illinois-ceesd/drivers_y3-prediction/data/cav5_comb2_ui/actii.FCStd

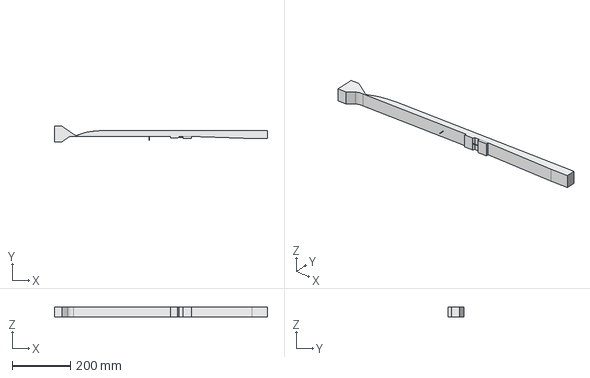
[picture p1: CAD file, 2023-10-13]
data/cav5_comb2_ui/actii.FCStd
728.8 x 54.1 x 35.0 mm
