illinois-ceesd/drivers_y3-prediction/data/cav8_comb2_ui/actii.FCStd

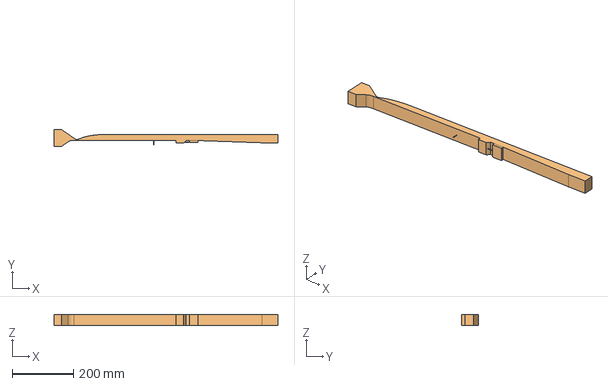
[picture p2: CAD file, 2023-10-13]
data/cav8_comb2_ui/actii.FCStd
728.8 x 54.1 x 35.0 mm
wallSurround
BooleanFragments
