illinois-ceesd/drivers_y3-prediction/data/jet_crossflow/actii_fillet.FCStd

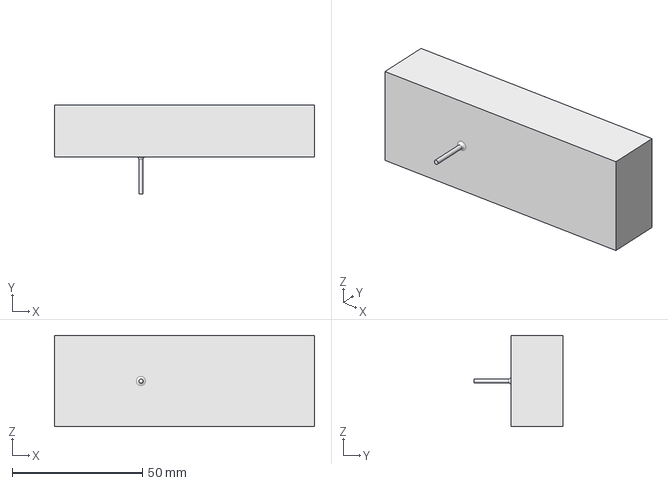
[picture p3: CAD file, 2023-10-16]
data/jet_crossflow/actii_fillet.FCStd
100.0 x 34.2 x 35.0 mm
