illinois-ceesd/drivers_y3-prediction/data/unstart_cr1p3/ACTII_Nozzle_Mach_4p5.STEP

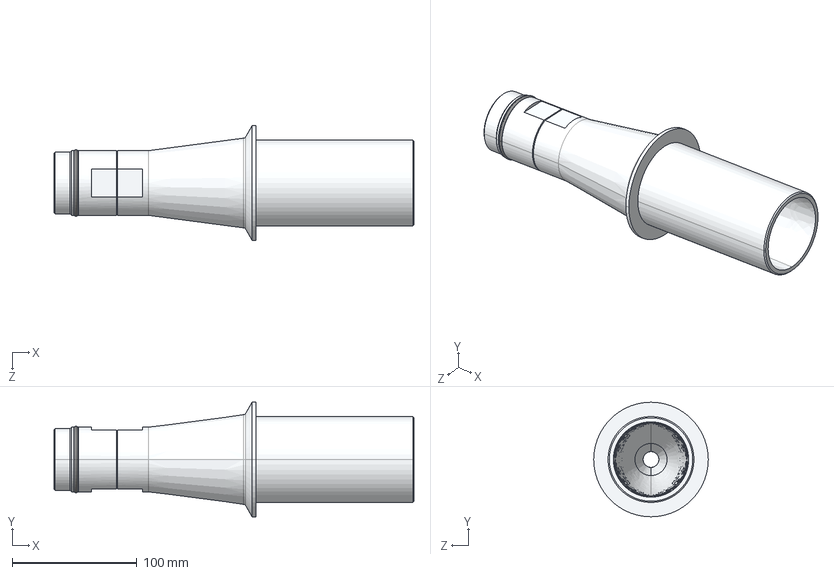
[picture p4: CAD file, 2024-04-18]
data/unstart_cr1p3/ACTII_Nozzle_Mach_4p5.STEP
289.0 x 92.0 x 92.0 mm
Mach-4p5-Divergent-Mod
Mach-4p5-Throat
o-rings_33
o-rings_47
