illinois-ceesd/drivers_y3-prediction/data/cav5_comb4_ui/actii.FCStd

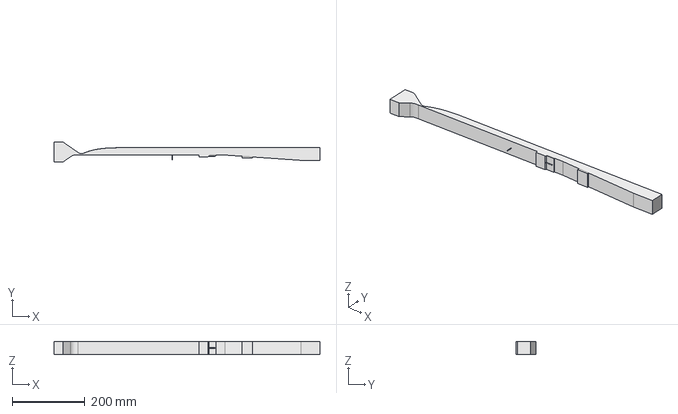
[picture p6: CAD file, 2023-07-18, an earlier design]
data/cav5_comb4_ui/actii.FCStd
728.8 x 54.1 x 35.0 mm
