illinois-ceesd/drivers_y3-prediction/(list of files, cad)

Other CAD files:
data/cav5_comb4/actii.FCStd
data/unstart_cr1p3/pseudoY0_2d.step
data/jet_crossflow/actii.FCStd
data/unstart_cr1p3/pseudoY0_2d.iges
data/unstart_cr1p3/pseudoY0_2d.stl
