illinois-ceesd/drivers_y3-prediction/(threads)

Thread 13 (2023-04-05):

Recent changes appear to render 3D mixtures inoperable

MTCam, 2023-04-05:
It seems that 3D mixtures no longer work after updates to AV/smoothness handling.   This happens on Lassen with a single GPU run in lazy execution mode with the KS feature set, even with `use_av=1`.

Updates:

We shouldn't call compiled functions from functions that are compiled.   There was a compiled function call down inside `unfiltered_rhs` which is itself compiled.   This would trigger with `use_av=1`.  Removing that compiled function call got us up to really long compiles (longer than we're wiling to wait).

Long compiles are mitigated by a liberal use of `force_evaluation` to make double sure we aren't getting any graphs representing constant data down inside the operator call graphs.  Compile times are acceptable now with AV=1, still testing other settings.

The current change set is summarized in #14

```
2023-04-05 03:43:53,438 - INFO - pyopencl - build program: kernel 'frozen_result' was part of a lengthy source build resulting from a binary cache miss (0.64 s)
******** Done Writing Visualization File ********
Traceback (most recent call last):
  File "/p/gpfs1/mtcampbe/CEESD/AutomatedTesting/MIRGE-Timing/timing/y3-prediction-testing/emirge/pytato/pytato/transform/__init__.py", line 190, in rec
    return self._cache[key]
           ~~~~~~~~~~~^^^^^
KeyError: DictOfNamedArrays({'_ary': Placeholder(axes=(Axis(tags=frozenset({DiscretizationElementAxisTag()})), Axis(tags=frozenset({DiscretizationDOFAxisTag()}))), tags={FEMEinsumTag(indices=((FreeEinsumIndex(discr_entity=DiscretizationElementAxisTag(), length=40179), FreeEinsumIndex(discr_entity=DiscretizationDOFAxisTag(), length=35)), (FreeEinsumIndex(discr_entity=DiscretizationElementAxisTag(), length=40179), FreeEinsumIndex(discr_entity=DiscretizationDOFAxisTag(), length=35))))}, shape=(40179, 35), dtype='float64', name='_actx_in_1_2_0')})

During handling of the above exception, another exception occurred:

Traceback (most recent call last):
  File "/p/gpfs1/mtcampbe/CEESD/AutomatedTesting/MIRGE-Timing/timing/y3-prediction-testing/emirge/pytato/pytato/transform/__init__.py", line 190, in rec
    return self._cache[key]
           ~~~~~~~~~~~^^^^^
KeyError: Placeholder(axes=(Axis(tags=frozenset({DiscretizationElementAxisTag()})), Axis(tags=frozenset({DiscretizationDOFAxisTag()}))), tags={FEMEinsumTag(indices=((FreeEinsumIndex(discr_entity=DiscretizationElementAxisTag(), length=40179), FreeEinsumIndex(discr_entity=DiscretizationDOFAxisTag(), length=35)), (FreeEinsumIndex(discr_entity=DiscretizationElementAxisTag(), length=40179), FreeEinsumIndex(discr_entity=DiscretizationDOFAxisTag(), length=35))))}, shape=(40179, 35), dtype='float64', name='_actx_in_1_2_0')

During handling of the above exception, another exception occurred:

Traceback (most recent call last):
  File "<frozen runpy>", line 198, in _run_module_as_main
  File "<frozen runpy>", line 88, in _run_code
  File "/p/gpfs1/mtcampbe/CEESD/AutomatedTesting/MIRGE-Timing/timing/y3-prediction-testing/emirge/miniforge3/envs/testing.y3.production/lib/python3.11/site-packages/mpi4py/__main__.py", line 7, in <module>
    main()
  File "/p/gpfs1/mtcampbe/CEESD/AutomatedTesting/MIRGE-Timing/timing/y3-prediction-testing/emirge/miniforge3/envs/testing.y3.production/lib/python3.11/site-packages/mpi4py/run.py", line 198, in main
    run_command_line(args)
  File "/p/gpfs1/mtcampbe/CEESD/AutomatedTesting/MIRGE-Timing/timing/y3-prediction-testing/emirge/miniforge3/envs/testing.y3.production/lib/python3.11/site-packages/mpi4py/run.py", line 47, in run_command_line
    run_path(sys.argv[0], run_name='__main__')
  File "<frozen runpy>", line 291, in run_path
  File "<frozen runpy>", line 98, in _run_module_code
  File "<frozen runpy>", line 88, in _run_code
  File "./driver.py", line 73, in <module>
    main(restart_filename=restart_filename, target_filename=target_filename,
  File "/p/gpfs1/mtcampbe/CEESD/AutomatedTesting/MIRGE-Timing/timing/y3-prediction-testing/emirge/mirgecom/mirgecom/mpi.py", line 200, in wrapped_func
    func(*args, **kwargs)
  File "/p/gpfs1/mtcampbe/CEESD/AutomatedTesting/MIRGE-Timing/timing/y3-prediction-testing/y3prediction/prediction.py", line 3129, in main
    advance_state(rhs=my_rhs, timestepper=timestepper,
  File "/p/gpfs1/mtcampbe/CEESD/AutomatedTesting/MIRGE-Timing/timing/y3-prediction-testing/emirge/mirgecom/mirgecom/steppers.py", line 439, in advance_state
    _advance_state_stepper_func(
  File "/p/gpfs1/mtcampbe/CEESD/AutomatedTesting/MIRGE-Timing/timing/y3-prediction-testing/emirge/mirgecom/mirgecom/steppers.py", line 164, in _advance_state_stepper_func
    state = timestepper(state=state, t=t, dt=dt, rhs=maybe_compiled_rhs)
            ^^^^^^^^^^^^^^^^^^^^^^^^^^^^^^^^^^^^^^^^^^^^^^^^^^^^^^^^^^^^
  File "/p/gpfs1/mtcampbe/CEESD/AutomatedTesting/MIRGE-Timing/timing/y3-prediction-testing/y3prediction/prediction.py", line 588, in _compiled_stepper_wrapper
    return compiled_lsrk45_step(actx, state, t, dt, rhs)
           ^^^^^^^^^^^^^^^^^^^^^^^^^^^^^^^^^^^^^^^^^^^^^
  File "/p/gpfs1/mtcampbe/CEESD/AutomatedTesting/MIRGE-Timing/timing/y3-prediction-testing/emirge/grudge/grudge/shortcuts.py", line 56, in compiled_lsrk45_step
    rhs_val = f(t + c*h, y)
              ^^^^^^^^^^^^^
  File "/p/gpfs1/mtcampbe/CEESD/AutomatedTesting/MIRGE-Timing/timing/y3-prediction-testing/y3prediction/prediction.py", line 3113, in my_rhs
    unfiltered_rhs_compiled(t, state)
  File "/p/gpfs1/mtcampbe/CEESD/AutomatedTesting/MIRGE-Timing/timing/y3-prediction-testing/emirge/arraycontext/arraycontext/impl/pytato/compile.py", line 337, in __call__
    output_template = self.f(
                      ^^^^^^^
  File "/p/gpfs1/mtcampbe/CEESD/AutomatedTesting/MIRGE-Timing/timing/y3-prediction-testing/y3prediction/prediction.py", line 2800, in unfiltered_rhs
    smoothness_mu = compute_smoothness_compiled(
                    ^^^^^^^^^^^^^^^^^^^^^^^^^^^^
  File "/p/gpfs1/mtcampbe/CEESD/AutomatedTesting/MIRGE-Timing/timing/y3-prediction-testing/emirge/arraycontext/arraycontext/impl/pytato/compile.py", line 329, in __call__
    return compiled_f(arg_id_to_arg)
           ^^^^^^^^^^^^^^^^^^^^^^^^^
  File "/p/gpfs1/mtcampbe/CEESD/AutomatedTesting/MIRGE-Timing/timing/y3-prediction-testing/emirge/grudge/grudge/array_context.py", line 380, in __call__
    input_args_for_prg = _args_to_device_buffers(
                         ^^^^^^^^^^^^^^^^^^^^^^^^
  File "/p/gpfs1/mtcampbe/CEESD/AutomatedTesting/MIRGE-Timing/timing/y3-prediction-testing/emirge/arraycontext/arraycontext/impl/pytato/compile.py", line 555, in _args_to_device_buffers
    arg = actx.freeze(arg)
          ^^^^^^^^^^^^^^^^
  File "/p/gpfs1/mtcampbe/CEESD/AutomatedTesting/MIRGE-Timing/timing/y3-prediction-testing/emirge/arraycontext/arraycontext/impl/pytato/__init__.py", line 491, in freeze
    normalized_expr, bound_arguments = _normalize_pt_expr(
                                       ^^^^^^^^^^^^^^^^^^^
  File "/p/gpfs1/mtcampbe/CEESD/AutomatedTesting/MIRGE-Timing/timing/y3-prediction-testing/emirge/arraycontext/arraycontext/impl/pytato/utils.py", line 92, in _normalize_pt_expr
    normalized_expr = normalize_mapper(expr)
                      ^^^^^^^^^^^^^^^^^^^^^^
  File "/p/gpfs1/mtcampbe/CEESD/AutomatedTesting/MIRGE-Timing/timing/y3-prediction-testing/emirge/pytato/pytato/transform/__init__.py", line 213, in __call__
    return self.rec(expr)  # type: ignore[no-any-return]
           ^^^^^^^^^^^^^^
  File "/p/gpfs1/mtcampbe/CEESD/AutomatedTesting/MIRGE-Timing/timing/y3-prediction-testing/emirge/pytato/pytato/transform/__init__.py", line 192, in rec
    result = super().rec(expr)  # type: ignore[type-var]
             ^^^^^^^^^^^^^^^^^
  File "/p/gpfs1/mtcampbe/CEESD/AutomatedTesting/MIRGE-Timing/timing/y3-prediction-testing/emirge/pytato/pytato/transform/__init__.py", line 163, in rec
    return method(expr, *args, **kwargs)
           ^^^^^^^^^^^^^^^^^^^^^^^^^^^^^
  File "/p/gpfs1/mtcampbe/CEESD/AutomatedTesting/MIRGE-Timing/timing/y3-prediction-testing/emirge/pytato/pytato/transform/__init__.py", line 307, in map_dict_of_named_arrays
    return DictOfNamedArrays({key: self.rec(val.expr)
                             ^^^^^^^^^^^^^^^^^^^^^^^^
  File "/p/gpfs1/mtcampbe/CEESD/AutomatedTesting/MIRGE-Timing/timing/y3-prediction-testing/emirge/pytato/pytato/transform/__init__.py", line 307, in <dictcomp>
    return DictOfNamedArrays({key: self.rec(val.expr)
                                   ^^^^^^^^^^^^^^^^^^
  File "/p/gpfs1/mtcampbe/CEESD/AutomatedTesting/MIRGE-Timing/timing/y3-prediction-testing/emirge/pytato/pytato/transform/__init__.py", line 192, in rec
    result = super().rec(expr)  # type: ignore[type-var]
             ^^^^^^^^^^^^^^^^^
  File "/p/gpfs1/mtcampbe/CEESD/AutomatedTesting/MIRGE-Timing/timing/y3-prediction-testing/emirge/pytato/pytato/transform/__init__.py", line 163, in rec
    return method(expr, *args, **kwargs)
           ^^^^^^^^^^^^^^^^^^^^^^^^^^^^^
  File "/p/gpfs1/mtcampbe/CEESD/AutomatedTesting/MIRGE-Timing/timing/y3-prediction-testing/emirge/arraycontext/arraycontext/impl/pytato/utils.py", line 76, in map_placeholder
    raise ValueError("Placeholders cannot appear in"
ValueError: Placeholders cannot appear in DatawrapperToBoundPlaceholderMapper.
--------------------------------------------------------------------------
MPI_ABORT was invoked on rank 0 in communicator MPI_COMM_WORLD
with errorcode 1.

NOTE: invoking MPI_ABORT causes Open MPI to kill all MPI processes.
You may or may not see output from other processes, depending on
exactly when Open MPI kills them.
--------------------------------------------------------------------------
```

Closed 2023-04-17.

Thread 19 (2023-04-17):

Large(ish) cases don't work with current driver@main

MTCam, 2023-04-17:
Scalability case on 128 ranks have started to fail with current driver@main.  Before recent changes, the code ran up to 512 ranks without issue.  Only the 128 rank case fails with this error.  512 has not been tested since this trouble started.

more details will follow, just want to get this on the radar.

```
2023-04-17 07:11:35,502 - INFO - meshmode.array_context - Array Contraction: completed (135.71s wall 1.00x CPU)
2023-04-17 07:11:35,503 - INFO - arraycontext.impl.pytato.compile - transform_loopy_program for 'unfiltered_rhs': completed (355.22s wall 1.00x CPU)
Traceback (most recent call last):
  File "<frozen runpy>", line 198, in _run_module_as_main
  File "<frozen runpy>", line 88, in _run_code
  File "/p/gpfs1/mtcampbe/CEESD/AutomatedTesting/MIRGE-Timing/timing/y3-prediction-testing/emirge/miniforge3/envs/prediction.env/lib/python3.11/site-packages/mpi4py/__main__.py", line 7, in <module>
    main()
  File "/p/gpfs1/mtcampbe/CEESD/AutomatedTesting/MIRGE-Timing/timing/y3-prediction-testing/emirge/miniforge3/envs/prediction.env/lib/python3.11/site-packages/mpi4py/run.py", line 198, in main
    run_command_line(args)
  File "/p/gpfs1/mtcampbe/CEESD/AutomatedTesting/MIRGE-Timing/timing/y3-prediction-testing/emirge/miniforge3/envs/prediction.env/lib/python3.11/site-packages/mpi4py/run.py", line 47, in run_command_line
    run_path(sys.argv[0], run_name='__main__')
  File "<frozen runpy>", line 291, in run_path
  File "<frozen runpy>", line 98, in _run_module_code
  File "<frozen runpy>", line 88, in _run_code
  File "driver.py", line 73, in <module>
    main(restart_filename=restart_filename, target_filename=target_filename,
  File "/p/gpfs1/mtcampbe/CEESD/AutomatedTesting/MIRGE-Timing/timing/y3-prediction-testing/emirge/mirgecom/mirgecom/mpi.py", line 200, in wrapped_func
    func(*args, **kwargs)
  File "/p/gpfs1/mtcampbe/CEESD/AutomatedTesting/MIRGE-Timing/timing/y3-prediction-testing/y3prediction/prediction.py", line 3096, in main
    advance_state(rhs=my_rhs, timestepper=timestepper,
  File "/p/gpfs1/mtcampbe/CEESD/AutomatedTesting/MIRGE-Timing/timing/y3-prediction-testing/emirge/mirgecom/mirgecom/steppers.py", line 439, in advance_state
    _advance_state_stepper_func(
  File "/p/gpfs1/mtcampbe/CEESD/AutomatedTesting/MIRGE-Timing/timing/y3-prediction-testing/emirge/mirgecom/mirgecom/steppers.py", line 164, in _advance_state_stepper_func
    state = timestepper(state=state, t=t, dt=dt, rhs=maybe_compiled_rhs)
            ^^^^^^^^^^^^^^^^^^^^^^^^^^^^^^^^^^^^^^^^^^^^^^^^^^^^^^^^^^^^
  File "/p/gpfs1/mtcampbe/CEESD/AutomatedTesting/MIRGE-Timing/timing/y3-prediction-testing/y3prediction/prediction.py", line 608, in _compiled_stepper_wrapper
    return compiled_lsrk45_step(actx, state, t, dt, rhs)
           ^^^^^^^^^^^^^^^^^^^^^^^^^^^^^^^^^^^^^^^^^^^^^
  File "/p/gpfs1/mtcampbe/CEESD/AutomatedTesting/MIRGE-Timing/timing/y3-prediction-testing/emirge/grudge/grudge/shortcuts.py", line 56, in compiled_lsrk45_step
    rhs_val = f(t + c*h, y)
              ^^^^^^^^^^^^^
  File "/p/gpfs1/mtcampbe/CEESD/AutomatedTesting/MIRGE-Timing/timing/y3-prediction-testing/y3prediction/prediction.py", line 3078, in my_rhs
    unfiltered_rhs_compiled(t, state)
  File "/p/gpfs1/mtcampbe/CEESD/AutomatedTesting/MIRGE-Timing/timing/y3-prediction-testing/emirge/arraycontext/arraycontext/impl/pytato/compile.py", line 366, in __call__
    compiled_func = self._dag_to_compiled_func(
                    ^^^^^^^^^^^^^^^^^^^^^^^^^^^
  File "/p/gpfs1/mtcampbe/CEESD/AutomatedTesting/MIRGE-Timing/timing/y3-prediction-testing/emirge/grudge/grudge/array_context.py", line 307, in _dag_to_compiled_func
    ) = self._dag_to_transformed_pytato_prg(
        ^^^^^^^^^^^^^^^^^^^^^^^^^^^^^^^^^^^^
  File "/p/gpfs1/mtcampbe/CEESD/AutomatedTesting/MIRGE-Timing/timing/y3-prediction-testing/emirge/arraycontext/arraycontext/impl/pytato/compile.py", line 442, in _dag_to_transformed_pytato_prg
    .with_transformed_program(self
     ^^^^^^^^^^^^^^^^^^^^^^^^^^^^^
  File "/p/gpfs1/mtcampbe/CEESD/AutomatedTesting/MIRGE-Timing/timing/y3-prediction-testing/emirge/pytato/pytato/target/loopy/__init__.py", line 151, in with_transformed_program
    return self.copy(program=f(self.program))
                             ^^^^^^^^^^^^^^^
  File "/p/gpfs1/mtcampbe/CEESD/AutomatedTesting/MIRGE-Timing/timing/y3-prediction-testing/emirge/meshmode/meshmode/array_context.py", line 1741, in transform_loopy_program
    raise err
  File "/p/gpfs1/mtcampbe/CEESD/AutomatedTesting/MIRGE-Timing/timing/y3-prediction-testing/emirge/meshmode/meshmode/array_context.py", line 1738, in transform_loopy_program
    iel_to_idofs = _get_iel_to_idofs(knl)
                   ^^^^^^^^^^^^^^^^^^^^^^
  File "/p/gpfs1/mtcampbe/CEESD/AutomatedTesting/MIRGE-Timing/timing/y3-prediction-testing/emirge/meshmode/meshmode/array_context.py", line 1068, in _get_iel_to_idofs
    raise NotImplementedError(f"Cannot fit loop nest '{insn.within_inames}'"
NotImplementedError: Cannot fit loop nest 'frozenset({'idof_ensm14'})' into known set of loop-nest patterns.
2023-04-17 07:11:36,495 - INFO - loopy.codegen - unfiltered_rhs: generate code: completed (16.88s wall 1.00x CPU)
2023-04-17 07:11:36,664 - INFO - loopy.schedule - unfiltered_rhs: schedule: completed (11.42s wall 1.00x CPU)
2023-04-17 07:11:37,738 - INFO - loopy.tools - contract_arrays on 'unfiltered_rhs': completed (130.51s wall 1.00x CPU)
2023-04-17 07:11:37,981 - INFO - pyopencl - build program: kernel 'unfiltered_rhs' was part of a lengthy source build resulting from a binary cache miss (6.77 s)
2023-04-17 07:11:39,042 - INFO - loopy.schedule - unfiltered_rhs: schedule: completed (10.97s wall 1.00x CPU)
2023-04-17 07:11:39,709 - INFO - loopy.codegen - unfiltered_rhs: generate code: completed (18.08s wall 1.00x CPU)
2023-04-17 07:11:39,800 - INFO - loopy.schedule - unfiltered_rhs: schedule: completed (4.37s wall 1.00x CPU)
2023-04-17 07:11:40,367 - INFO - loopy.schedule - unfiltered_rhs: schedule: completed (18.51s wall 1.00x CPU)
2023-04-17 07:11:40,484 - INFO - meshmode.array_context - Array Contraction: completed (138.73s wall 1.00x CPU)
2023-04-17 07:11:40,486 - INFO - arraycontext.impl.pytato.compile - transform_loopy_program for 'unfiltered_rhs': completed (357.87s wall 1.00x CPU)
Traceback (most recent call last):
  File "<frozen runpy>", line 198, in _run_module_as_main
  File "<frozen runpy>", line 88, in _run_code
  File "/p/gpfs1/mtcampbe/CEESD/AutomatedTesting/MIRGE-Timing/timing/y3-prediction-testing/emirge/miniforge3/envs/prediction.env/lib/python3.11/site-packages/mpi4py/__main__.py", line 7, in <module>
    main()
  File "/p/gpfs1/mtcampbe/CEESD/AutomatedTesting/MIRGE-Timing/timing/y3-prediction-testing/emirge/miniforge3/envs/prediction.env/lib/python3.11/site-packages/mpi4py/run.py", line 198, in main
    run_command_line(args)
  File "/p/gpfs1/mtcampbe/CEESD/AutomatedTesting/MIRGE-Timing/timing/y3-prediction-testing/emirge/miniforge3/envs/prediction.env/lib/python3.11/site-packages/mpi4py/run.py", line 47, in run_command_line
    run_path(sys.argv[0], run_name='__main__')
  File "<frozen runpy>", line 291, in run_path
  File "<frozen runpy>", line 98, in _run_module_code
  File "<frozen runpy>", line 88, in _run_code
  File "driver.py", line 73, in <module>
    main(restart_filename=restart_filename, target_filename=target_filename,
  File "/p/gpfs1/mtcampbe/CEESD/AutomatedTesting/MIRGE-Timing/timing/y3-prediction-testing/emirge/mirgecom/mirgecom/mpi.py", line 200, in wrapped_func
    func(*args, **kwargs)
  File "/p/gpfs1/mtcampbe/CEESD/AutomatedTesting/MIRGE-Timing/timing/y3-prediction-testing/y3prediction/prediction.py", line 3096, in main
    advance_state(rhs=my_rhs, timestepper=timestepper,
  File "/p/gpfs1/mtcampbe/CEESD/AutomatedTesting/MIRGE-Timing/timing/y3-prediction-testing/emirge/mirgecom/mirgecom/steppers.py", line 439, in advance_state
    _advance_state_stepper_func(
  File "/p/gpfs1/mtcampbe/CEESD/AutomatedTesting/MIRGE-Timing/timing/y3-prediction-testing/emirge/mirgecom/mirgecom/steppers.py", line 164, in _advance_state_stepper_func
    state = timestepper(state=state, t=t, dt=dt, rhs=maybe_compiled_rhs)
            ^^^^^^^^^^^^^^^^^^^^^^^^^^^^^^^^^^^^^^^^^^^^^^^^^^^^^^^^^^^^
  File "/p/gpfs1/mtcampbe/CEESD/AutomatedTesting/MIRGE-Timing/timing/y3-prediction-testing/y3prediction/prediction.py", line 608, in _compiled_stepper_wrapper
    return compiled_lsrk45_step(actx, state, t, dt, rhs)
           ^^^^^^^^^^^^^^^^^^^^^^^^^^^^^^^^^^^^^^^^^^^^^
  File "/p/gpfs1/mtcampbe/CEESD/AutomatedTesting/MIRGE-Timing/timing/y3-prediction-testing/emirge/grudge/grudge/shortcuts.py", line 56, in compiled_lsrk45_step
    rhs_val = f(t + c*h, y)
              ^^^^^^^^^^^^^
  File "/p/gpfs1/mtcampbe/CEESD/AutomatedTesting/MIRGE-Timing/timing/y3-prediction-testing/y3prediction/prediction.py", line 3078, in my_rhs
    unfiltered_rhs_compiled(t, state)
  File "/p/gpfs1/mtcampbe/CEESD/AutomatedTesting/MIRGE-Timing/timing/y3-prediction-testing/emirge/arraycontext/arraycontext/impl/pytato/compile.py", line 366, in __call__
    compiled_func = self._dag_to_compiled_func(
                    ^^^^^^^^^^^^^^^^^^^^^^^^^^^
  File "/p/gpfs1/mtcampbe/CEESD/AutomatedTesting/MIRGE-Timing/timing/y3-prediction-testing/emirge/grudge/grudge/array_context.py", line 307, in _dag_to_compiled_func
    ) = self._dag_to_transformed_pytato_prg(
        ^^^^^^^^^^^^^^^^^^^^^^^^^^^^^^^^^^^^
  File "/p/gpfs1/mtcampbe/CEESD/AutomatedTesting/MIRGE-Timing/timing/y3-prediction-testing/emirge/arraycontext/arraycontext/impl/pytato/compile.py", line 442, in _dag_to_transformed_pytato_prg
    .with_transformed_program(self
     ^^^^^^^^^^^^^^^^^^^^^^^^^^^^^
  File "/p/gpfs1/mtcampbe/CEESD/AutomatedTesting/MIRGE-Timing/timing/y3-prediction-testing/emirge/pytato/pytato/target/loopy/__init__.py", line 151, in with_transformed_program
    return self.copy(program=f(self.program))
                             ^^^^^^^^^^^^^^^
  File "/p/gpfs1/mtcampbe/CEESD/AutomatedTesting/MIRGE-Timing/timing/y3-prediction-testing/emirge/meshmode/meshmode/array_context.py", line 1741, in transform_loopy_program
    raise err
  File "/p/gpfs1/mtcampbe/CEESD/AutomatedTesting/MIRGE-Timing/timing/y3-prediction-testing/emirge/meshmode/meshmode/array_context.py", line 1738, in transform_loopy_program
    iel_to_idofs = _get_iel_to_idofs(knl)
                   ^^^^^^^^^^^^^^^^^^^^^^
  File "/p/gpfs1/mtcampbe/CEESD/AutomatedTesting/MIRGE-Timing/timing/y3-prediction-testing/emirge/meshmode/meshmode/array_context.py", line 1068, in _get_iel_to_idofs
    raise NotImplementedError(f"Cannot fit loop nest '{insn.within_inames}'"
NotImplementedError: Cannot fit loop nest 'frozenset({'idof_ensm16'})' into known set of loop-nest patterns.
2023-04-17 07:11:41,867 - INFO - loopy.schedule - unfiltered_rhs: schedule: completed (11.63s wall 1.00x CPU)
2023-04-17 07:11:43,640 - INFO - loopy.tools - contract_arrays on 'unfiltered_rhs': completed (128.28s wall 1.00x CPU)
```

ZwFink, 2023-09-18:
This is happening to me on `smoke_test_ks_3d` using 4 ranks.
````bash
  File "/usr/WS2/fink12/drivers_y3-prediction/emirge/meshmode/meshmode/array_context.py", line 1068, in _get_iel_to_idofs
    raise NotImplementedError(f"Cannot fit loop nest '{insn.within_inames}'"
NotImplementedError: Cannot fit loop nest 'frozenset({'idof_ensm2'})' into known set of loop-nest patterns.
```

Am I the only one?

majosm, 2023-09-18:
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

https://github.com/illinois-ceesd/mirgecom/issues/944

A fix is still TBD. Depending on what you're doing, you may be able to avoid it by setting `use_wall: False` in `run_params.yaml`.

Closed 2024-05-07.

Thread 27 (2023-04-26):

ESDG status and failure

MTCam, 2023-04-26:
Here's the current state of ESDG in prediction.   To reproduce, checkout from #26, use `buildMirge.sh` (or install mirgecom@production-esdg), and try to run smoke test or anything else with `--esdg` option.   This works on single-volume cases, but not with multivolume.  Here's the current error:

```
Traceback (most recent call last):
  File "/p/gpfs1/mtcampbe/CEESD/AutomatedTesting/MIRGE-Timing/esdg.testing/emirge/miniforge3/envs/production.esdg/lib/python3.11/site-packages/pytools/__init__.py", line 931, in new_inner
    return self.cache_dict[args]
           ~~~~~~~~~~~~~~~^^^^^^
KeyError: ()

During handling of the above exception, another exception occurred:

Traceback (most recent call last):
  File "/p/gpfs1/mtcampbe/CEESD/AutomatedTesting/MIRGE-Timing/esdg.testing/emirge/miniforge3/envs/production.esdg/lib/python3.11/site-packages/pytools/__init__.py", line 931, in new_inner
    return self.cache_dict[args]
           ~~~~~~~~~~~~~~~^^^^^^
KeyError: ()

During handling of the above exception, another exception occurred:

Traceback (most recent call last):
  File "/p/gpfs1/mtcampbe/CEESD/AutomatedTesting/MIRGE-Timing/esdg.testing/emirge/grudge/grudge/discretization.py", line 601, in _volume_discr_from_dd
    base_volume_discr = self._volume_discrs[dd.domain_tag.tag]
                        ~~~~~~~~~~~~~~~~~~~^^^^^^^^^^^^^^^^^^^
KeyError: <class 'grudge.dof_desc.VTAG_ALL'>

During handling of the above exception, another exception occurred:

Traceback (most recent call last):
  File "<frozen runpy>", line 198, in _run_module_as_main
  File "<frozen runpy>", line 88, in _run_code
  File "/p/gpfs1/mtcampbe/CEESD/AutomatedTesting/MIRGE-Timing/esdg.testing/emirge/miniforge3/envs/production.esdg/lib/python3.11/site-packages/mpi4py/__main__.py", line 7, in <module>
    main()
  File "/p/gpfs1/mtcampbe/CEESD/AutomatedTesting/MIRGE-Timing/esdg.testing/emirge/miniforge3/envs/production.esdg/lib/python3.11/site-packages/mpi4py/run.py", line 198, in main
    run_command_line(args)
  File "/p/gpfs1/mtcampbe/CEESD/AutomatedTesting/MIRGE-Timing/esdg.testing/emirge/miniforge3/envs/production.esdg/lib/python3.11/site-packages/mpi4py/run.py", line 47, in run_command_line
    run_path(sys.argv[0], run_name='__main__')
  File "<frozen runpy>", line 291, in run_path
  File "<frozen runpy>", line 98, in _run_module_code
  File "<frozen runpy>", line 88, in _run_code
  File "./driver.py", line 75, in <module>
    main(restart_filename=restart_filename, target_filename=target_filename,
  File "/p/gpfs1/mtcampbe/CEESD/AutomatedTesting/MIRGE-Timing/esdg.testing/emirge/mirgecom/mirgecom/mpi.py", line 200, in wrapped_func
    func(*args, **kwargs)
  File "/p/gpfs1/mtcampbe/CEESD/AutomatedTesting/MIRGE-Timing/esdg.testing/y3prediction/prediction.py", line 3066, in main
    advance_state(rhs=my_rhs, timestepper=timestepper,
  File "/p/gpfs1/mtcampbe/CEESD/AutomatedTesting/MIRGE-Timing/esdg.testing/emirge/mirgecom/mirgecom/steppers.py", line 439, in advance_state
    _advance_state_stepper_func(
  File "/p/gpfs1/mtcampbe/CEESD/AutomatedTesting/MIRGE-Timing/esdg.testing/emirge/mirgecom/mirgecom/steppers.py", line 164, in _advance_state_stepper_func
    state = timestepper(state=state, t=t, dt=dt, rhs=maybe_compiled_rhs)
            ^^^^^^^^^^^^^^^^^^^^^^^^^^^^^^^^^^^^^^^^^^^^^^^^^^^^^^^^^^^^
  File "/p/gpfs1/mtcampbe/CEESD/AutomatedTesting/MIRGE-Timing/esdg.testing/emirge/mirgecom/mirgecom/integrators/lsrk.py", line 67, in euler_step
    return lsrk_step(EulerCoefs, state, t, dt, rhs)
           ^^^^^^^^^^^^^^^^^^^^^^^^^^^^^^^^^^^^^^^^
  File "/p/gpfs1/mtcampbe/CEESD/AutomatedTesting/MIRGE-Timing/esdg.testing/emirge/mirgecom/mirgecom/integrators/lsrk.py", line 53, in lsrk_step
    k = coefs.A[i]*k + dt*rhs(t + coefs.C[i]*dt, state)
                          ^^^^^^^^^^^^^^^^^^^^^^^^^^^^^
  File "/p/gpfs1/mtcampbe/CEESD/AutomatedTesting/MIRGE-Timing/esdg.testing/y3prediction/prediction.py", line 3050, in my_rhs
    unfiltered_rhs_compiled(t, state)
  File "/p/gpfs1/mtcampbe/CEESD/AutomatedTesting/MIRGE-Timing/esdg.testing/emirge/arraycontext/arraycontext/impl/pytato/compile.py", line 337, in __call__
    output_template = self.f(
                      ^^^^^^^
  File "/p/gpfs1/mtcampbe/CEESD/AutomatedTesting/MIRGE-Timing/esdg.testing/y3prediction/prediction.py", line 2891, in unfiltered_rhs
    ns_rhs, wall_energy_rhs = coupled_ns_heat_operator(
                              ^^^^^^^^^^^^^^^^^^^^^^^^^
  File "/p/gpfs1/mtcampbe/CEESD/AutomatedTesting/MIRGE-Timing/esdg.testing/emirge/mirgecom/mirgecom/multiphysics/thermally_coupled_fluid_wall.py", line 1275, in coupled_ns_heat_operator
    fluid_op_result = fluid_operator(
                      ^^^^^^^^^^^^^^^
  File "/p/gpfs1/mtcampbe/CEESD/AutomatedTesting/MIRGE-Timing/esdg.testing/emirge/mirgecom/mirgecom/navierstokes.py", line 642, in entropy_stable_ns_operator
    -volume_flux_differencing(dcoll, dd_vol_quad, dd_allfaces_quad,
     ^^^^^^^^^^^^^^^^^^^^^^^^^^^^^^^^^^^^^^^^^^^^^^^^^^^^^^^^^^^^^^
  File "/p/gpfs1/mtcampbe/CEESD/AutomatedTesting/MIRGE-Timing/esdg.testing/emirge/grudge/grudge/flux_differencing.py", line 265, in volume_flux_differencing
    return rec_map_subarrays(
           ^^^^^^^^^^^^^^^^^^
  File "/p/gpfs1/mtcampbe/CEESD/AutomatedTesting/MIRGE-Timing/esdg.testing/emirge/grudge/grudge/tools.py", line 208, in rec_map_subarrays
    return map_array_container(
           ^^^^^^^^^^^^^^^^^^^^
  File "/p/gpfs1/mtcampbe/CEESD/AutomatedTesting/MIRGE-Timing/esdg.testing/emirge/arraycontext/arraycontext/container/traversal.py", line 274, in map_array_container
    return deserialize_container(ary, [
                                      ^
  File "/p/gpfs1/mtcampbe/CEESD/AutomatedTesting/MIRGE-Timing/esdg.testing/emirge/arraycontext/arraycontext/container/traversal.py", line 275, in <listcomp>
    (key, f(subary)) for key, subary in iterable
          ^^^^^^^^^
  File "/p/gpfs1/mtcampbe/CEESD/AutomatedTesting/MIRGE-Timing/esdg.testing/emirge/grudge/grudge/tools.py", line 204, in rec_map_subarrays
    return map_subarrays(
           ^^^^^^^^^^^^^^
  File "/p/gpfs1/mtcampbe/CEESD/AutomatedTesting/MIRGE-Timing/esdg.testing/emirge/grudge/grudge/tools.py", line 141, in map_subarrays
    return f(ary)
           ^^^^^^
  File "/p/gpfs1/mtcampbe/CEESD/AutomatedTesting/MIRGE-Timing/esdg.testing/emirge/grudge/grudge/flux_differencing.py", line 260, in _hybridized_div
    return sum(_single_axis_hybridized_derivative_kernel(
           ^^^^^^^^^^^^^^^^^^^^^^^^^^^^^^^^^^^^^^^^^^^^^^
  File "/p/gpfs1/mtcampbe/CEESD/AutomatedTesting/MIRGE-Timing/esdg.testing/emirge/grudge/grudge/flux_differencing.py", line 260, in <genexpr>
    return sum(_single_axis_hybridized_derivative_kernel(
               ^^^^^^^^^^^^^^^^^^^^^^^^^^^^^^^^^^^^^^^^^^
  File "/p/gpfs1/mtcampbe/CEESD/AutomatedTesting/MIRGE-Timing/esdg.testing/emirge/grudge/grudge/flux_differencing.py", line 218, in _single_axis_hybridized_derivative_kernel
    inverse_jac_matrix()
  File "/p/gpfs1/mtcampbe/CEESD/AutomatedTesting/MIRGE-Timing/esdg.testing/emirge/grudge/grudge/flux_differencing.py", line 188, in inverse_jac_matrix
    return _inv_surf_metric_deriv()
           ^^^^^^^^^^^^^^^^^^^^^^^^
  File "/p/gpfs1/mtcampbe/CEESD/AutomatedTesting/MIRGE-Timing/esdg.testing/emirge/miniforge3/envs/production.esdg/lib/python3.11/site-packages/pytools/__init__.py", line 933, in new_inner
    result = inner(*args)
             ^^^^^^^^^^^^
  File "/p/gpfs1/mtcampbe/CEESD/AutomatedTesting/MIRGE-Timing/esdg.testing/emirge/grudge/grudge/flux_differencing.py", line 171, in _inv_surf_metric_deriv
    [
  File "/p/gpfs1/mtcampbe/CEESD/AutomatedTesting/MIRGE-Timing/esdg.testing/emirge/grudge/grudge/flux_differencing.py", line 173, in <listcomp>
    [
  File "/p/gpfs1/mtcampbe/CEESD/AutomatedTesting/MIRGE-Timing/esdg.testing/emirge/grudge/grudge/flux_differencing.py", line 176, in <listcomp>
    area_element(actx, dcoll)
  File "/p/gpfs1/mtcampbe/CEESD/AutomatedTesting/MIRGE-Timing/esdg.testing/emirge/grudge/grudge/geometry/metrics.py", line 672, in area_element
    return actx.thaw(_area_elements())
                     ^^^^^^^^^^^^^^^^
  File "/p/gpfs1/mtcampbe/CEESD/AutomatedTesting/MIRGE-Timing/esdg.testing/emirge/miniforge3/envs/production.esdg/lib/python3.11/site-packages/pytools/__init__.py", line 933, in new_inner
    result = inner(*args)
             ^^^^^^^^^^^^
  File "/p/gpfs1/mtcampbe/CEESD/AutomatedTesting/MIRGE-Timing/esdg.testing/emirge/grudge/grudge/geometry/metrics.py", line 665, in _area_elements
    pseudoscalar(
  File "/p/gpfs1/mtcampbe/CEESD/AutomatedTesting/MIRGE-Timing/esdg.testing/emirge/grudge/grudge/geometry/metrics.py", line 637, in pseudoscalar
    return parametrization_derivative(
           ^^^^^^^^^^^^^^^^^^^^^^^^^^^
  File "/p/gpfs1/mtcampbe/CEESD/AutomatedTesting/MIRGE-Timing/esdg.testing/emirge/grudge/grudge/geometry/metrics.py", line 601, in parametrization_derivative
    dim = dcoll.discr_from_dd(dd).dim
          ^^^^^^^^^^^^^^^^^^^^^^^
  File "/p/gpfs1/mtcampbe/CEESD/AutomatedTesting/MIRGE-Timing/esdg.testing/emirge/miniforge3/envs/production.esdg/lib/python3.11/site-packages/pytools/__init__.py", line 777, in wrapper
    result = function(obj, *args, **kwargs)
             ^^^^^^^^^^^^^^^^^^^^^^^^^^^^^^
  File "/p/gpfs1/mtcampbe/CEESD/AutomatedTesting/MIRGE-Timing/esdg.testing/emirge/grudge/grudge/discretization.py", line 365, in discr_from_dd
    return self._volume_discr_from_dd(dd)
           ^^^^^^^^^^^^^^^^^^^^^^^^^^^^^^
  File "/p/gpfs1/mtcampbe/CEESD/AutomatedTesting/MIRGE-Timing/esdg.testing/emirge/miniforge3/envs/production.esdg/lib/python3.11/site-packages/pytools/__init__.py", line 777, in wrapper
    result = function(obj, *args, **kwargs)
             ^^^^^^^^^^^^^^^^^^^^^^^^^^^^^^
  File "/p/gpfs1/mtcampbe/CEESD/AutomatedTesting/MIRGE-Timing/esdg.testing/emirge/grudge/grudge/discretization.py", line 603, in _volume_discr_from_dd
    raise ValueError("a volume discretization with volume tag "
ValueError: a volume discretization with volume tag '<class 'grudge.dof_desc.VTAG_ALL'>' is not known
```

Closed 2023-04-26.
