illinois-ceesd/drivers_y3-prediction/y3prediction/pyro_mechs/uiuc_bound_cp.yaml

description: |-
  Modified version of UIUC mechanism

generator: cti2yaml
cantera-version: 2.6.0
date: Wed, 27 Jul 2022 18:13:24 -0500
input-files: [uiuc_Sharp.cti]

units: {length: cm, quantity: mol, activation-energy: cal/mol}

phases:
- name: gas
  thermo: ideal-gas
  elements: [O, H, C, N]
  species: [C2H4, O2, CO2, CO, H2O, H2, N2]
  kinetics: gas
  reactions: all
  transport: mixture-averaged
  state:
    T: 300.0
    P: 1.01325e+05

species:
- name: O2
  composition: {O: 2}
  thermo:
    model: NASA7
    temperature-ranges: [50.0, 1000.0, 6000.0]
    data:
    - [3.3625982879046, -2.75301645330651E-06, 2.04226666018565E-06, -1.20665444163695E-09, 0, -1063.94356, 3.65767573]
    - [3.6441176454853, 0.000646414432661291, -1.00626310785635E-07, 5.5517226390456E-12, 0, -1258.80052621656, 1.73121921648199]
  transport:
    model: gas
    geometry: linear
    diameter: 3.458
    well-depth: 107.4
    polarizability: 1.6
    rotational-relaxation: 3.8
  note: TPIS89
- name: H2O
  composition: {H: 2, O: 1}
  thermo:
    model: NASA7
    temperature-ranges: [50.0, 2000.0, 6000.0]
    data:
    - [3.95858864602834, -0.000175726158627177, 1.81002662158116E-06, -7.0786721708685E-10, 6.50011944247605E-14, -30293.7267, -0.849032208]
    - [4.62591833656212, 0.000946420098943144, -7.26216815885404E-08, -4.93452361781564E-13, 0, -31265.7705356708, -6.02666126447272]
  transport:
    model: gas
    geometry: nonlinear
    diameter: 2.605
    well-depth: 572.4
    dipole: 1.844
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
  orders: {C2H4: 0.5, O2: 0.65}
- equation: ' CO + 0.5 O2 <=> CO2'  # Reaction 2
  rate-constant: {A: 1.1e+07, b: 0.7, Ea: 11000}
- equation: ' H2 + 0.5 O2 => H2O'  # Reaction 3
  rate-constant: {A: 7.0e+08, b: 0.0, Ea: 12000.0}
  orders: {H2: 0.75, O2: 0.5}
