illinois-ceesd/drivers_y3-prediction/smoke_test_parsl/make_viz_params.yaml

viz_level: 2
viz_order: 4
use_sponge: True
use_injection: False
nhealth: -1
nstatus: -1
#constant_cfl: 1
smooth_char_length: 0
use_av: 2
constant_cfl: 0
current_cfl: 0.05
current_dt: 1e-10
t_final: 2e-9
vel_sigma: 250
temp_sigma: 250
nspecies:  2
order:  2
integrator: euler
advance_time: False
