illinois-ceesd/drivers_y3-prediction/smoke_test_parsl/run_params.yaml

nviz: -1
viz_level: 2
viz_interval_type: 0
#viz_interval_type: 1
#viz_interval_type: 2
t_viz_interval: 1.e-9
wall_time_scale: 10000
wall_penalty_amount: 0
use_sponge: True
use_injection: False
nrestart: 5
nhealth: 1
nstatus: 1
#constant_cfl: 1
smooth_char_length: 5
use_av: 0
constant_cfl: 0
current_cfl: 0.05
current_dt: 1e-10
t_final: 2e-9
vel_sigma: 250
temp_sigma: 250
nspecies:  2
order:  2
alpha_sc: 0.01
s0_sc: -5.0
kappa_sc: 0.5
integrator: euler
#integrator: compiled_lsrk54
#integrator: lsrk54
#health_pres_min: 2828
#health_pres_max: 274259
