illinois-ceesd/drivers_y3-prediction/(commit log)

2023-03-01 it lives
    [actii.FCStd]
2023-03-01 rework reading yaml input to use configurator
    [run_params.yaml]
2023-03-02 Update for smoke-test driver for Y3 smoke testing.
2023-03-07 add filter options to experiment run
2023-03-08 work around long compile issue with filtering
2023-03-29 Don't run ks3d case yet, grid gen needs attn.
    Fixes mirgecom production CI.
2023-04-10 simplify diffusion by removing the coupled data exchanges on the boundary
2023-04-18 make cache rank-local, not PID-local
2023-04-25 add a couple force_eval for good measure
2023-05-11 new health checking to pinpoint crash location
    [run_params.yaml]
2023-07-13 adding nowall option (#32)
    * adding data and ci test for nowall
    * 3d nowall mesh
    * bug in no wall for av>0
    * refactor stepper_state, clean up viz/status reporting
    * oops
    * working on fixing wall grad
    * updates to get use_av=1 working
    * updates
    * update injection init
    * works for viz
    * working for wall and nowall now
    * updates
    * fix restart
    * debuggin stuff
    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
    [run_params.yaml]
2023-07-13 switched ks_3d to bigger mesh
2023-07-18 bug fixes in upstream injection, disabling wall_char_length_smoothing
    [run_params.yaml]
2023-07-18 add the missing upstream injector meshing
    [actii.FCStd]
2023-08-22 Use `extract_volumes` to set up the mesh in the no-wall case (#41)
    * use extract_volumes to set up the mesh in the no-wall case
    * change smoke_test_nw data symlink
2023-08-24 Add ESDG testing to CI (#37)
    * Add ESDG testing to CI
    * Change mode for runscript
    * Spello
    * More specific msg for flux setting.
    * Add carriage return to flux info msg.
    * Do not try to run 4 ranks in lazy smoke test.
    * Make messaging jibe better with existing messaging, better error if no esdg support.
    * Spaco
    * Fix zeros_like issue when running numpy context
    * Use numpy context when running esdg, for fast turn-around.
    * Update ESDG numerical flux setting
    * Deflakate and spell esdg flux correctly.
    * Rename flux msg var.
    * Reset mesh link to align with main.
2023-08-24 Testing scalability data collect (#23)
    * Update driver temporarily trying to reduce compile time
    * Update driver temporarily trying to reduce compile time
    * Update
    * update
    * Update parameters
    * Add batch mesh maker script
    * update scalability
    * Get longer allocations
    * Update
    * Add esdg option
    * gel options a bit, set branch in buildmirge
    * gel options better
    * Add esdg parameters, options.
    * seperate conda env name
    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
    [run_params.yaml]
2023-08-25 improve bc selection and fix a bug (#44)
    * improve bc selection and fix a bug
    * add missing boundary specification in rhs
    * fix bug for nowwall
    * Update y3prediction/prediction.py
    * Update y3prediction/prediction.py
    * Update y3prediction/prediction.py
    * Update y3prediction/prediction.py
    * formatting
    ---------
    [run_params.yaml]
2023-08-29 reworked init to consider gamma function of temperature (#45)
    [run_params.yaml]
2023-09-05 Add shock1d (#47)
    * refactor for boundary conditions
    * clean up some prints
    * all smoke_tests working
    * missing shock1d init
    * cleanup
    * missing smoke_test
    * sponges for different init cases, outflow boundary types
    [run_params.yaml]
2023-09-14 Enhance health checking and syncing a bit to try to catch errant pred… (#49)
    * Enhance health checking and syncing a bit to try to catch errant prediction sim
    * limit what's checked
    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
2023-09-18 new meshing for prediction runs
    [actii.FCStd]
2023-09-26 added jet in crossflow mesh
    [actii.FCStd]
2023-09-28 updates to jet_crossflow meshing
    [actii.FCStd]
2023-10-12 added new 3d meshes for 8mm cavity, updated 5mm cavity to have jcf meshing
    [actii.FCStd]
2023-10-13 modifications to cad
    [actii.FCStd]
2023-10-16 jcf fillet
    [actii_fillet.FCStd]
2023-11-14 implementation for AV D (#52)
    * implementation for AV D
    * changes to support artificial species diffusivity
    * updating some viz outputs
    * point at correct mirgecom branch
    * add some code to handle legacy artificial viscosity restarts
    * set back to production
    [run_params.yaml]
2023-11-29 add new mech with updated temperature fits for T<1000K
2023-12-04 allow non-smooth velocity/temperture in shock1d
2024-04-16 TPE + Limiters (#55)
    * working examples now with tensor product elements
    * updates to enable quads
    * support new limiter
    * support new limiter
    * element average and neighbor value sharing, added pressure limiting
    * Update tpe params, init, and mesh rotation.
    * Add quad mesh, smoke_test for quads.
    * updated limiter
    * updated to limiting, works with multi-species now
    * try and limit minimum density
    * Revert some charlen stuff, add quad params.
    * Remove stale comment
    * Use correct actx creation API instead of hokey actx creation in driver.
    * Use latest mirgecom tpe branch
    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
    [ACTII_Nozzle_Mach_4p5.STEP, Circular_scramjet_low_enthalpy_config.STEP]
2024-04-18 Update run_params.yaml (#57)
    Use correct data type for limiter option.
    [run_params.yaml]
2024-05-06 Limiter testing (#59)
    * added ideal gas limiter tests and limter bug fixes
    * add pytest to ci
    * add pytest fix
    * add pytest fix
    * add pytest fix
    * comment out stuff
    * bug
    * updates to limiting
    * multi species limiter fixes
    * updated limiter and added new pyro fits
    * flake*
    * pylint
    * update ci
    * update ci
    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
    [run_params.yaml, uiuc_bound_cp.yaml]
2024-06-19 Mixing layer (#62)
    * sample workflow
    * works
    * add parsl to packages
    * initial working parsl version
    * stuff
    * updated paraview viz
    * working on parsl viz
    * working on 3d slicing
    * workflow updates
    * working for multi-thread runs
    * async parsl viz dump creation
    * modifying paraview viz to work better with parsl
    * fixed making viz img
    * adding mixing layer initializer and mesh
    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
    [pseudoY0_2d.iges, pseudoY0_2d.step, pseudoY0_2d.stl]
2024-08-29 Test m to n restart (#67)
    * smoke test for m2n restart
    * adding m2n smoke test to ci
    * point to m2n mirgecom branch
    * oversubscribe m2n test
    * missing stuff
    * update to production
    [run_params.yaml]
2024-10-24 Change scaling test scripting to help support multiple platforms (#68)
    * add scripts for tioga, specify nnodes for tioga
    * Take 2 hours for the batch job just in case, use nrank-specific inputs
    * Revert actii.msh link to mesh in repo
2025-02-24 Optimize coupled operators again (#76)
    * port Matt's commits, still needs axisymetric fixes
    * fixed axisym
2025-02-26 avoid recalculating operator fluid states when they're passed into coupled_ns_heat_operator (#78)
2025-03-03 added new shock_1d test case for performance testing
2025-06-05 Production (#88)
    * new changes and new branch
    * Limiter update (#69)
    * changes to limiting for local entropy minimum
    * forward step init and mesh
    * forward step init and mesh
    * udpates to mesh generation
    * Change scaling test scripting to help support multiple platforms (#68)
    * limiter tweaks
    * debugging mass fractions
    * 2 bug fixes
    * cleaning up
    * add schlieren to viz
    * add schlieren to viz
    * fix mesh conversion to support triangles
    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
    [run_params.yaml]
2025-06-05 Production (#89)
    * trying some stuff
    * changes to limiter to move entropy_min out o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
